willz1200/Hexa-Driver/Documentation/README.md

Documentation for Hexa Driver PCB & Software
