willz1200/Hexa-Driver/Documentation/Project Management/Git_CheatSheet.md

* git config --global user.email "your@email.com"
* git config --global user.name "username"
* git clone https://github.com/willz1200/Hexa-Driver.git
* git add .
* git add -A
* git commit -m "this is a change..."
* git push
* git status
* git pull
* git branch
* git diff
* git branch [branch-name]
* git checkout [branch-name]
* git merge [branch]
* git push origin pid
* git push origin --delete pid
