willz1200/Hexa-Driver/Documentation/Project Management/Firmware plan.pptx

## Firmware plan

## Development plan

- PID loop working
  - Modeling the motor
  - Analyzing
  - Control.

## Slide 3

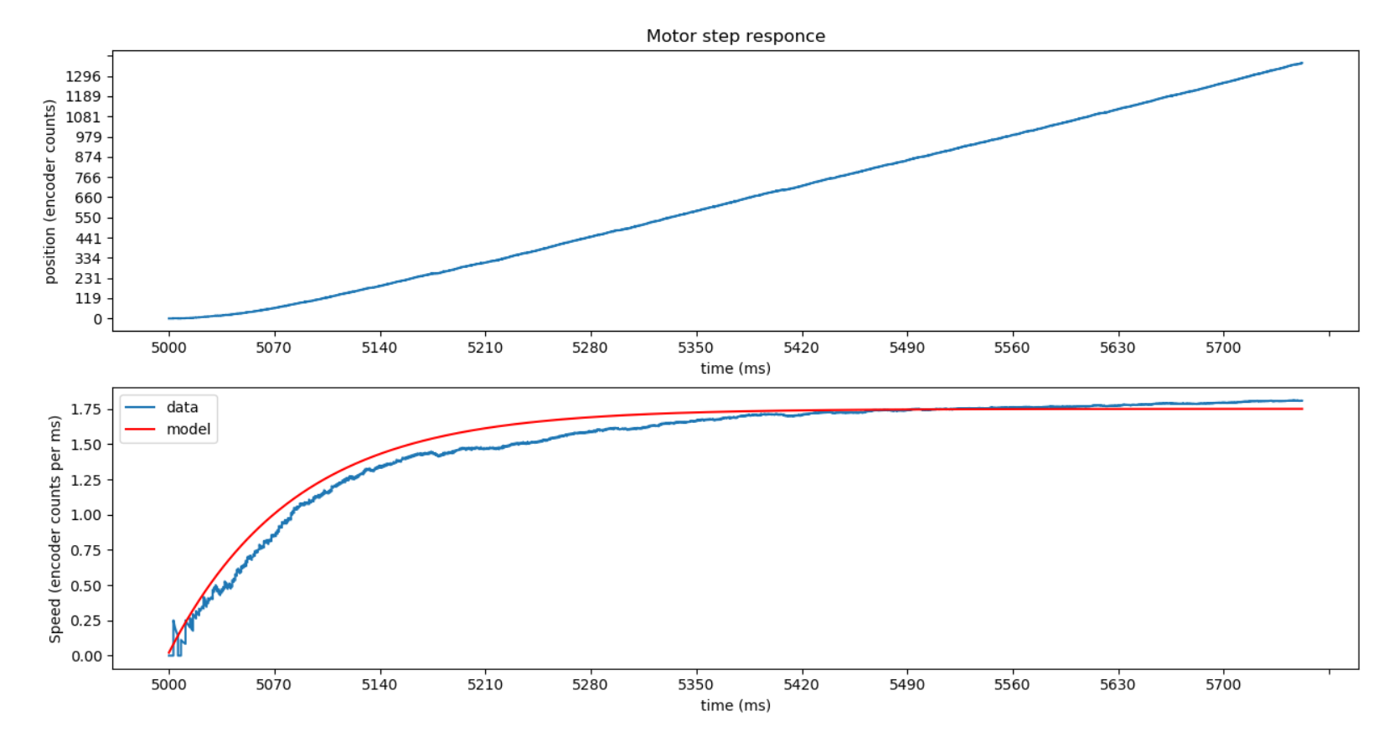
[picture p3: figure]
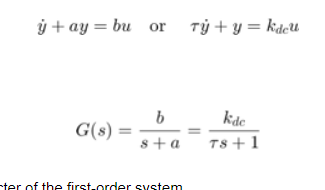
[picture p4: figure]

Y(t) = A(1 - e-t/T)

T =83
A = 1.75

## Slide 4

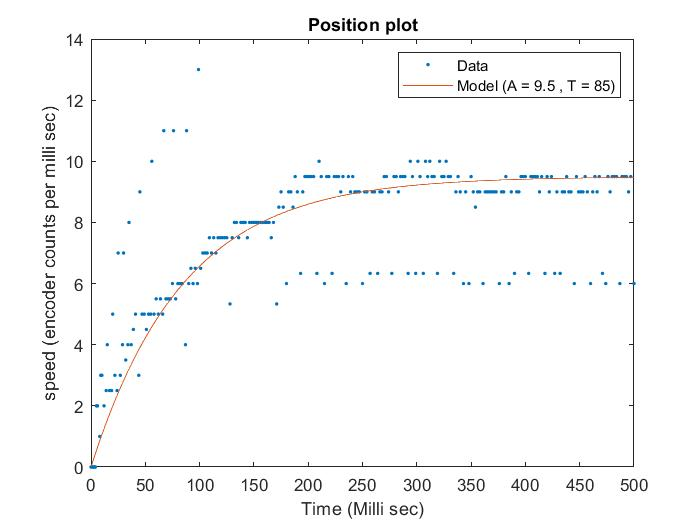
[picture p5: figure]

## Slide 5

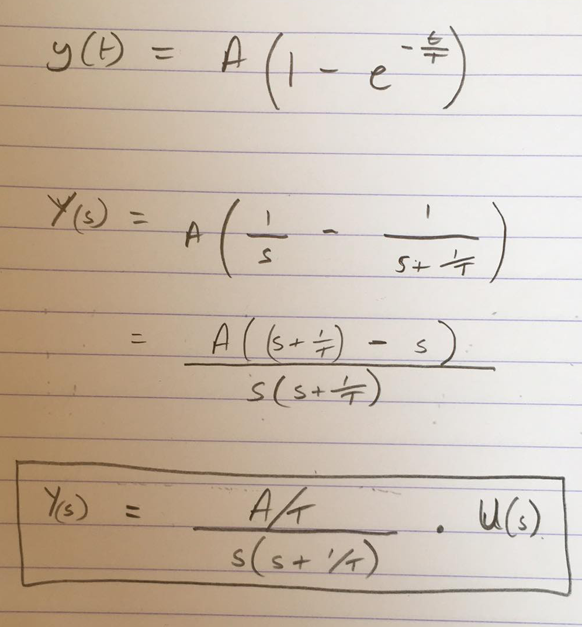
[picture p6: figure]

## Slide 6

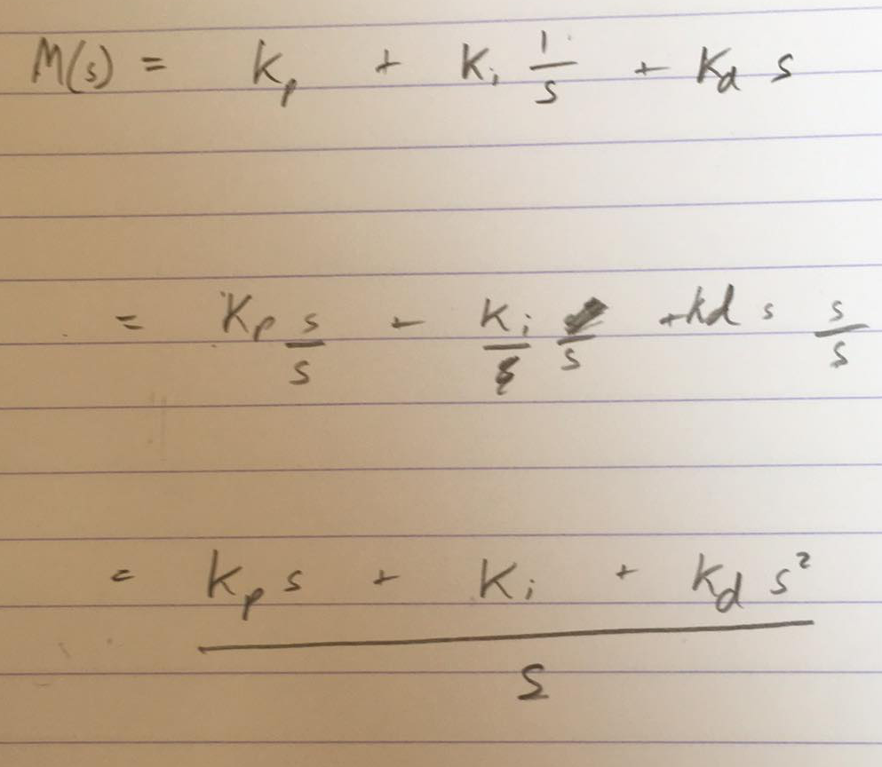
[picture p7: figure]
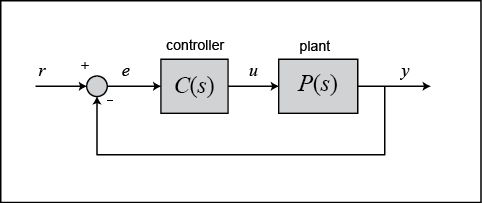
[picture p8: figure]
Image result for transfer function of a pid controller

## State space representation?

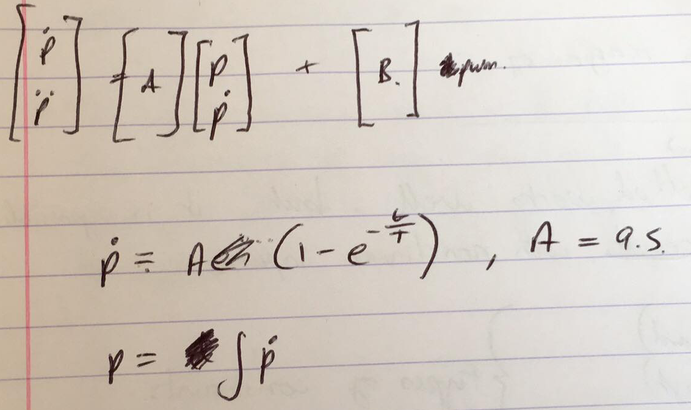
[picture p9: figure]

http://ctms.engin.umich.edu/CTMS/index.php?example=MotorPosition&section=ControlStateSpace

http://ctms.engin.umich.edu/CTMS/index.php?example=MotorSpeed&section=SystemModeling

## State space model.

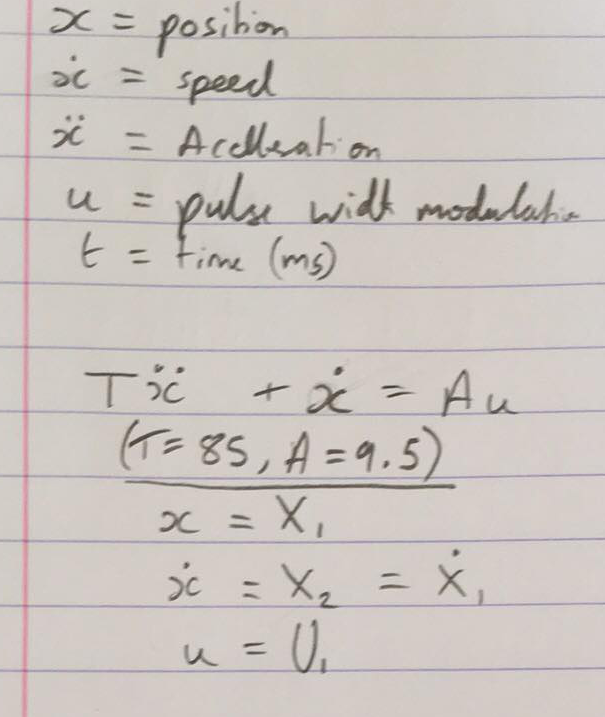
[picture p10: figure]
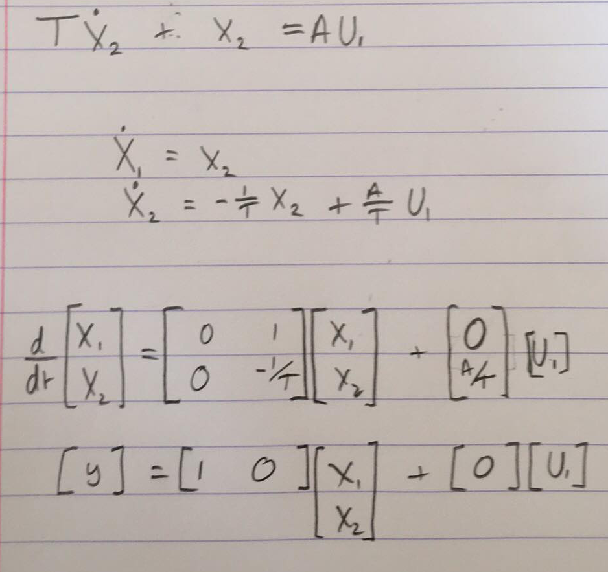
[picture p11: figure]

## Open loop step response

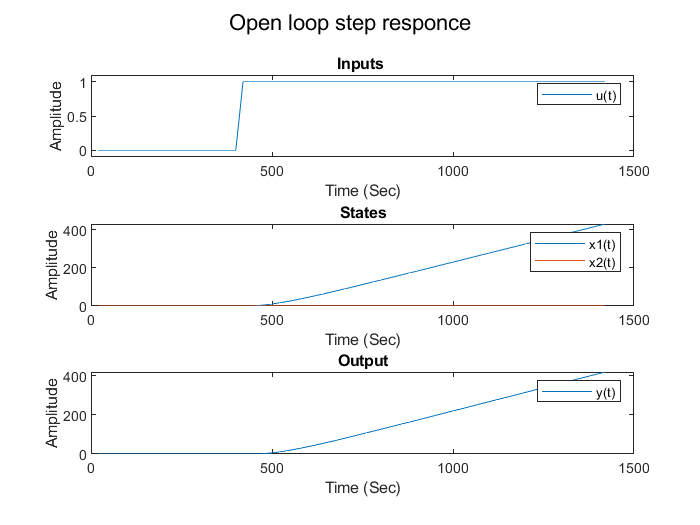
[picture p12: figure]

## Closed loop IH LQR

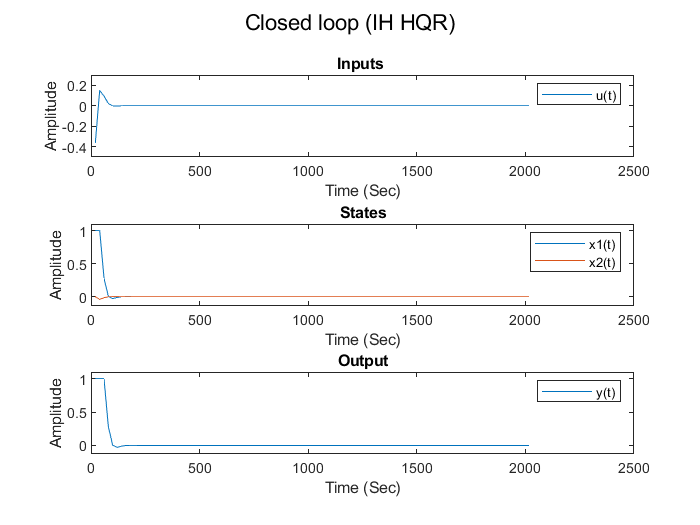
[picture p13: figure]
