willz1200/Hexa-Driver/Documentation/PCB-Dimensions-Hexa-Driver-Rev1_00.pdf

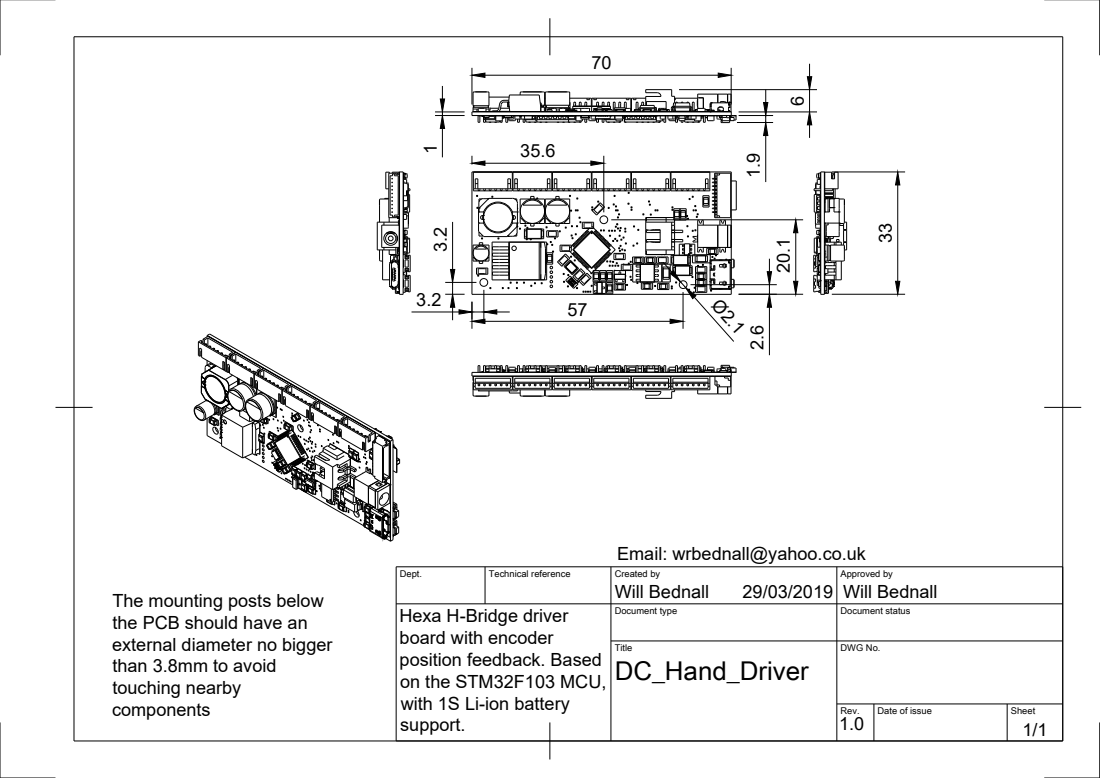
[picture p14: page 1]
Dept.; Technical reference; Created by; Approved by; Document type; Document status; Title; DWG No.; Rev.; Date of issue; Sheet; Will Bednall

1 Hexa H-Bridge driver

Email: wrbednall@yahoo.co.uk

The mounting posts below
the PCB should have an
external diameter no bigger
than 3.8mm to avoid
touching nearby
components

board with encoder
position feedback. Based
on the STM32F103 MCU,
with 1S Li-ion battery
support.
