willz1200/Hexa-Driver/Firmware/Hexa/CommandDefinitions.h

/******************************************************************************
 * @File		CommandDefinitions.h
 * @Brief		Put your custom commands in here
 * @Date		27/11/2019 (Last Updated)
 * @Author(s)	William Bednall
 ******************************************************************************/
#ifndef CommandDefinitions_h
#define CommandDefinitions_h

#include "Controller.h"
#include "CommandLineInterface.h"

extern Controller *Dev_LA;
//extern uint8_t spinRunning;
void ledfunc();
void stepResponse();
void lsFunc();
void spinFunc();
void posGainFunc();
void velGainFunc();
void velIntGainFunc();
void setpointFunc();
void setSampleRateFunc();
void togPosVelFunc();
void togSDKmodeFunc();
void moveSetPoint();
void configRunTimeController();
void setWorkspaceLA();
void operationalLA();

//Commands cannot contain spaces or `
#define cmd_total 15
const cmdFormat cmd_bind[cmd_total] PROGMEM = {
	{ "led", ledfunc },
	{ "step", stepResponse },
	{ "ls", lsFunc },
	{ "r", spinFunc },
	{ "pp", posGainFunc },
	{ "vp", velGainFunc },
	{ "vi", velIntGainFunc },
	{ "s", setpointFunc },
	{ "t", setSampleRateFunc },
	{ "v", togPosVelFunc },
	{ "z", togSDKmodeFunc },
	{ "mv", moveSetPoint },
	{ "rt", configRunTimeController },
	{ "w", setWorkspaceLA },
	{ "o", operationalLA }
};

#endif
