willz1200/Hexa-Driver/(commit log)

2019-04-12 Create PinDefinitionsRev1_00.h
    Pin definitions for revision 1.00 of the hexa driver PCB
2019-04-12 Delete PinDefinitionsRev1_00.h
    Indent Mode Error, Re-uploading
    [PinDefinitionsRev1_00.h]
2019-04-12 Add files via upload
    PDF showing the PCB Dimensions
2019-04-13 Update PinDefinitionsRev1_00.h
    Added flip data for encoders with swapped C1/C2 on the PCB
    [PinDefinitionsRev1_00.h]
2019-04-13 Update .editorconfig
    arduino ino file support added
2019-11-13 Added the backend for the command line interface, also added an led test command
2019-11-13 added some error messaging ideas
    [CommandDefinitions.cpp]
2019-11-13 Added encoder position command
2019-11-18 Created new controller class, made linear actuator class into a base class of the controller class. Cleaned up the linear actuator instantiation pin definitions. Added closedSpinTest as a controller.
2019-11-18 Position controller implemented! Very jittery but it works :) Commands added to toggle controller and set gain/setpoint.
    [CommandDefinitions.cpp, CommandDefinitions.h, Controller.cpp, Controller.h, Hexa.ino]
2019-11-20 Added encoder velocity calculation to linear actuator class
2019-11-20 Added gear reduction ratio
2019-11-20 Fixed velocity calculations to work for both positive and negative velocity
    [LinearActuator.cpp, LinearActuator.h]
2019-11-20 Created controller update function, added set sample rate command
2019-11-20 Added Dev_LA pointer to ease LA swapping
    [CommandDefinitions.cpp, CommandDefinitions.h, Controller.cpp, Controller.h, Hexa.ino]
2019-11-20 Added toggle command for position and velocity data streaming
2019-11-20 Added s prefix and time to position and velocity stream data
2019-11-21 First attempt at implementing a velocity PI stage, not yet working
2019-11-21 Hidden PI stage debug data
2019-11-21 Added time based controller to allow motor position without any feedback... Double Janky! ;)
2019-11-22 Fixed position and velocity streaming
    [Hexa.ino]
2019-11-27 Added command to enable/disable linear actuator, added command to change the current linear actuator which all the commands are linked to
2019-11-27 Added current linear actuator workspace list view and enable/disable checkbox for each linear actuator
2019-12-04 chainged the type of a variable to save on memory
2019-12-11 Add firmware plan power point
2020-02-14 Triggering a broken build for testing
    [Hexa.ino]
2020-02-14 Testing on firmware action CI complete, fixing bug
    [Hexa.ino]
